labcat73/LED_Star/doc/LED Star - 3D.png

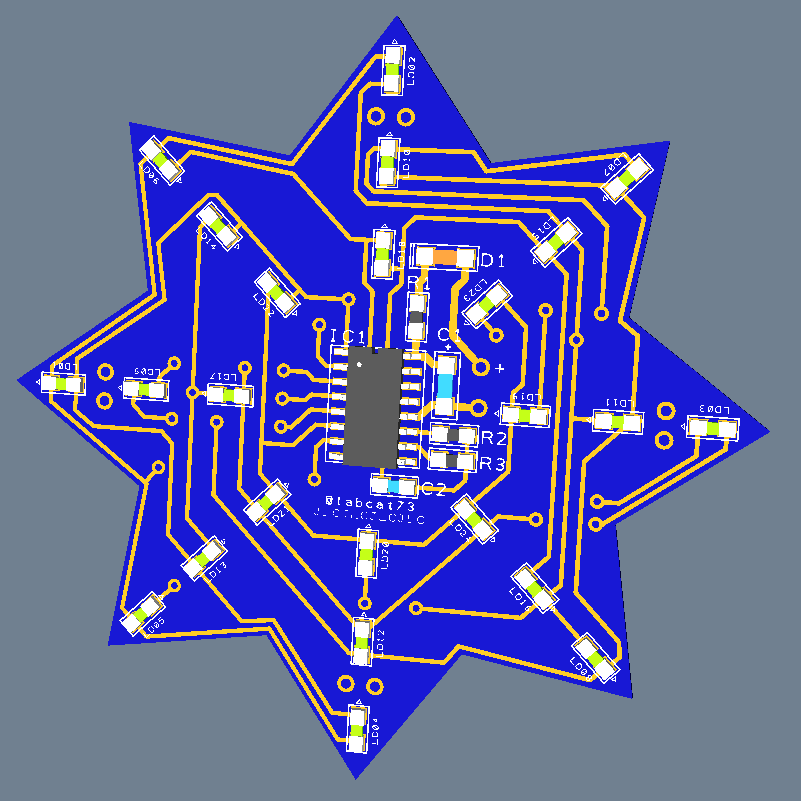
doc/LED Star - 3D.png
