labcat73/LED_Star/doc/LED Star - PCB.pdf

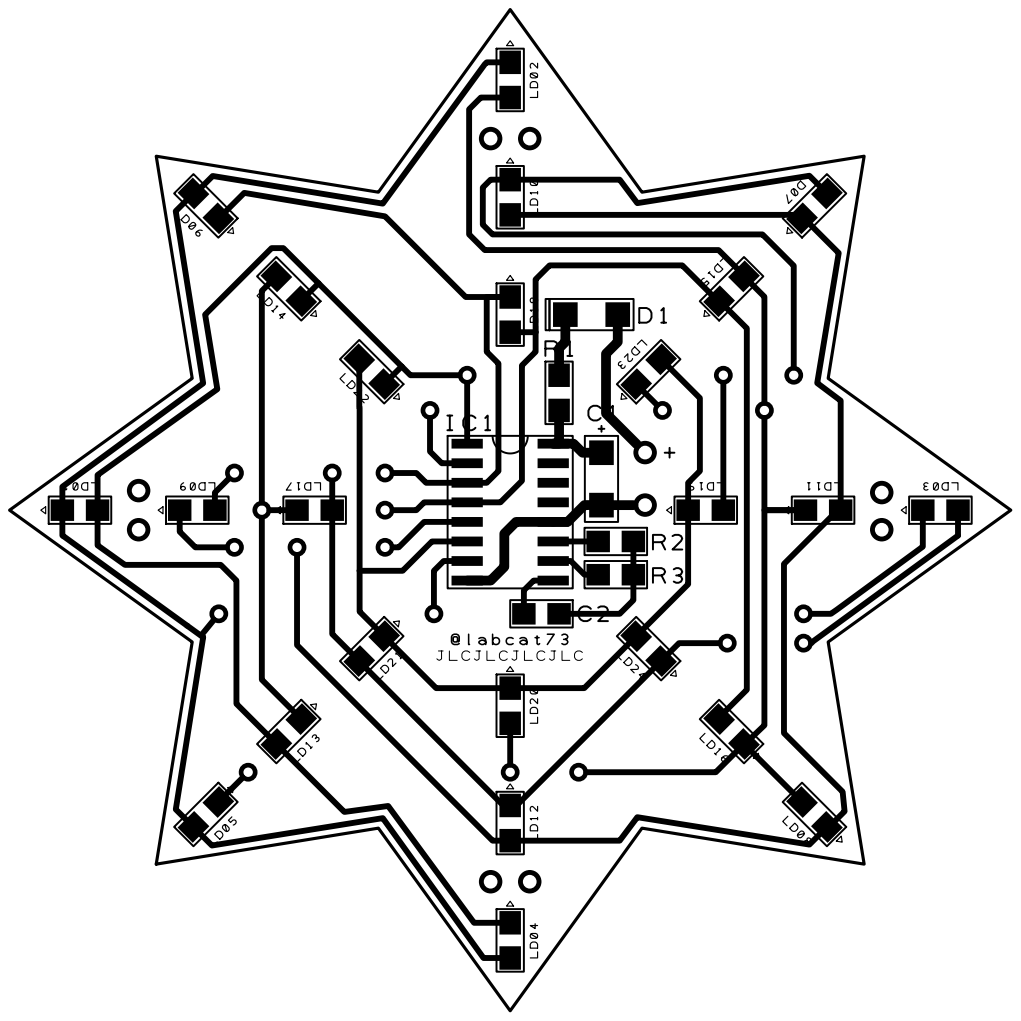
[picture p2: page 1]
