labcat73/LED_Star/doc/LED Star - Project.pdf

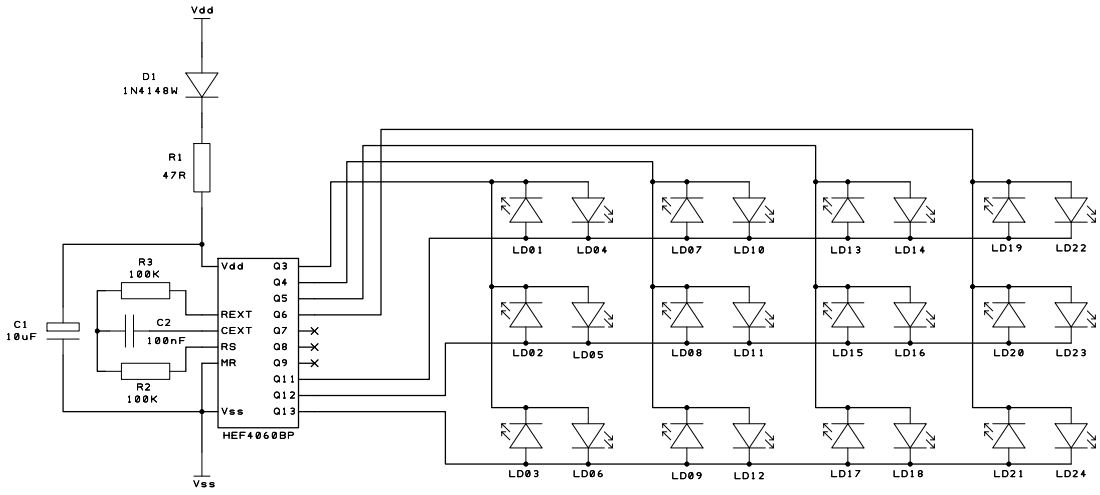
[picture p3: page 1]
