labcat73/LED_Star/(list of files, drawings)

Other design files:
LED Star.pcb
